bit-bots/bitbots_imu_dxl/electronics/imu_module/schematic.pdf

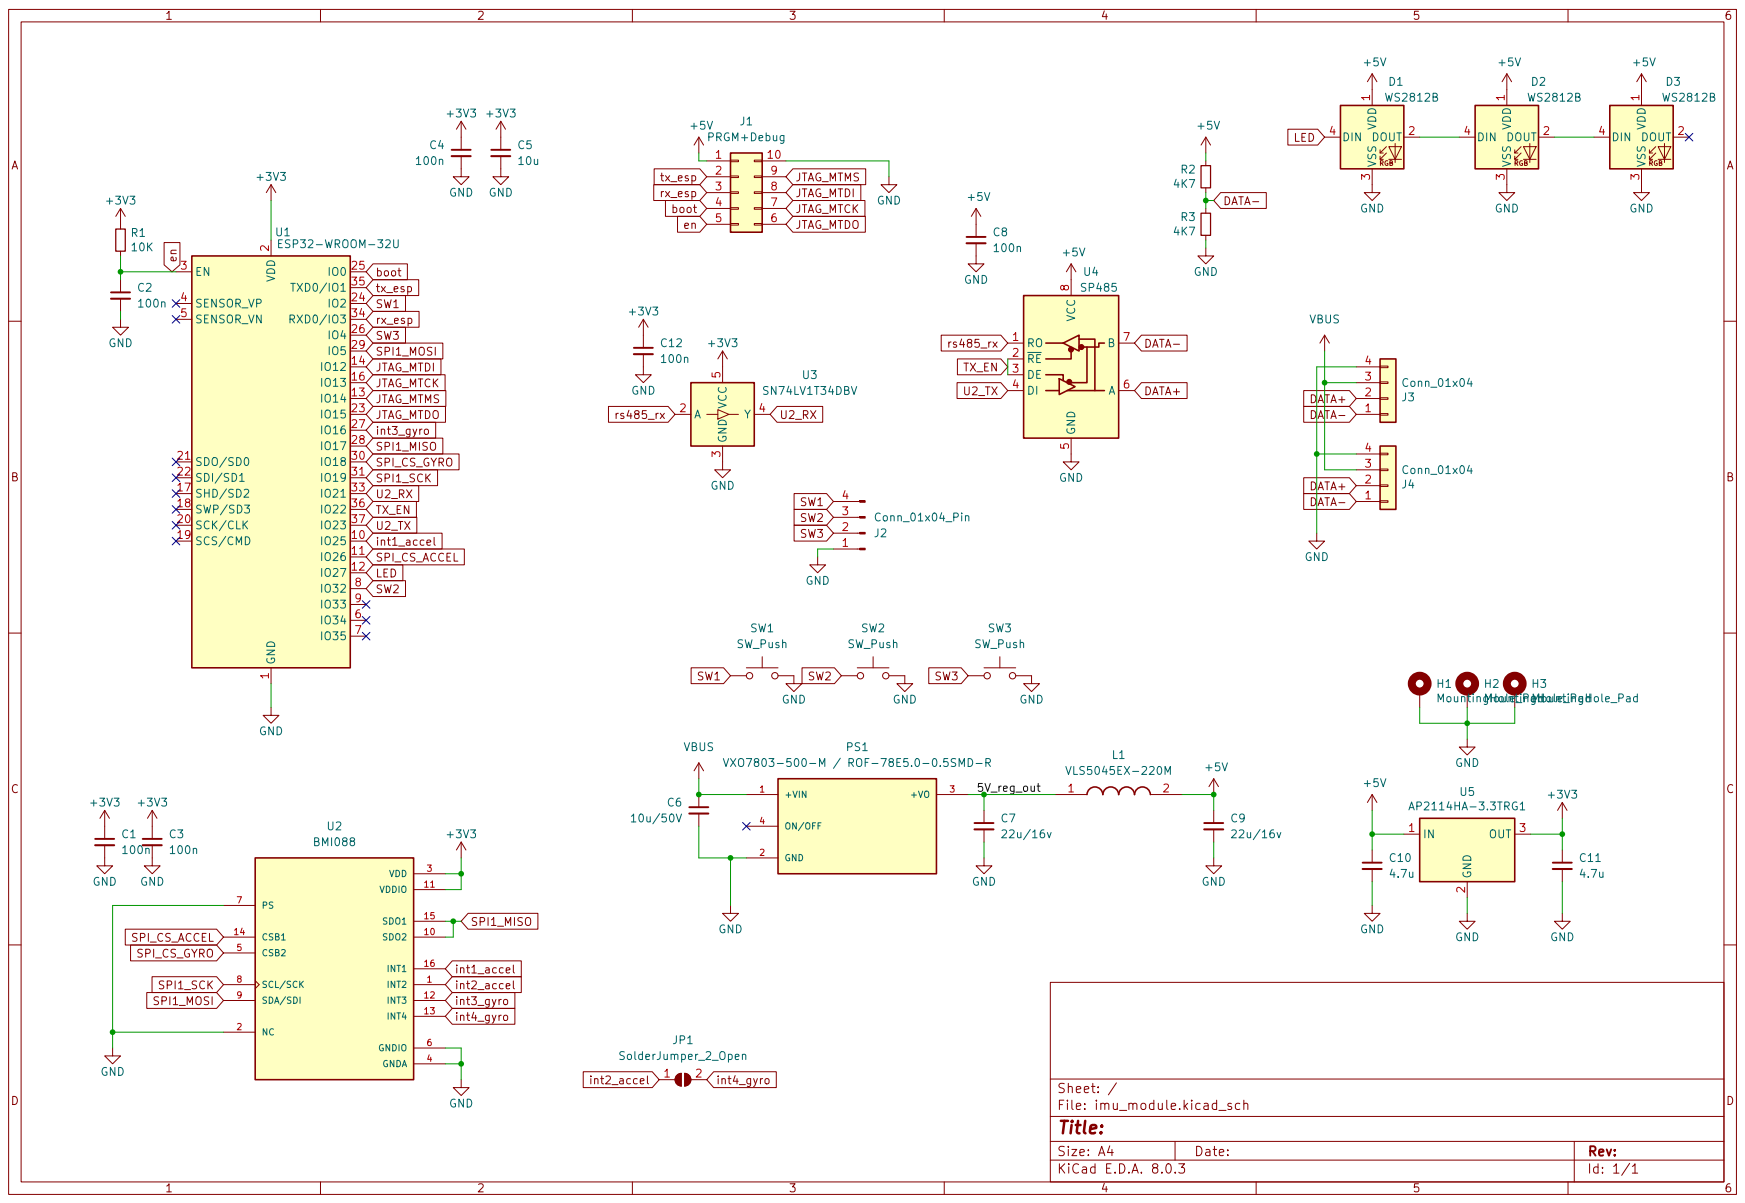
[picture p1: page 1]
