bit-bots/bitbots_imu_dxl/electronics/imu_module/imu_module.kicad_pcb

## KiCad design electronics/imu_module/imu_module.kicad_pcb (2024-07-10)

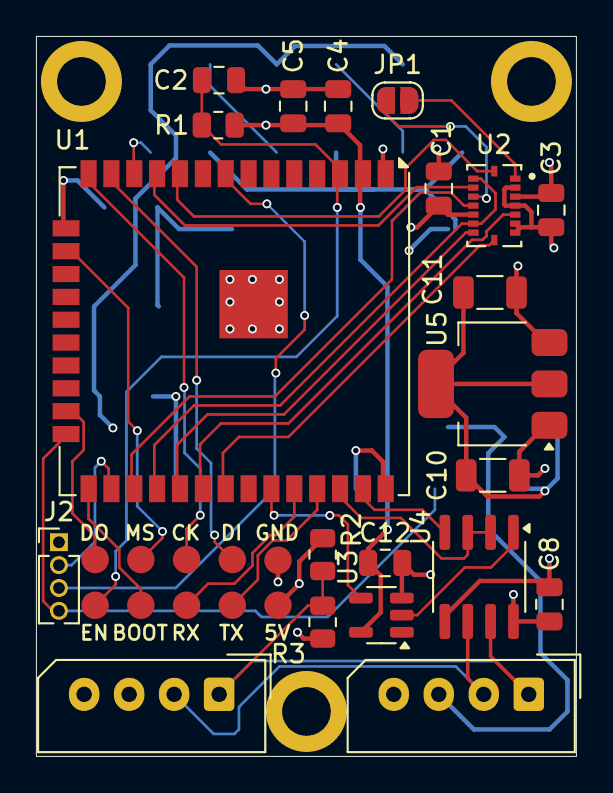
[picture p2: board imu_module.kicad_pcb from above]

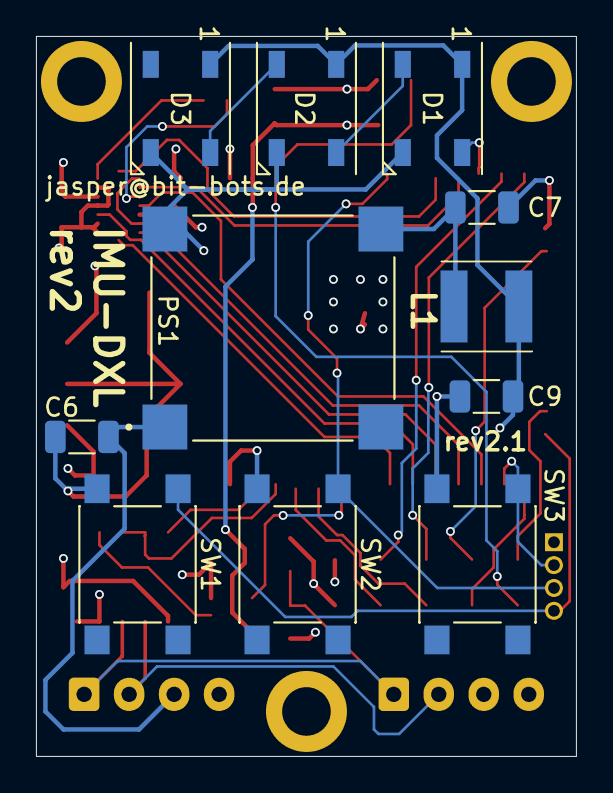
[picture p3: board imu_module.kicad_pcb from below]

Board: 4 copper layers, 30.0 x 40.0 mm, 36 parts (11 on the bottom side), 34 nets.

Parts:
C1, C2, C3, C4, C8, C12: 100n; C_0805_2012Metric
C5: 10u; C_0805_2012Metric
C6: 10u/50V; C_1206_3216Metric
C7, C9: 22u/16v; C_1206_3216Metric
C10, C11: 4.7u; C_1206_3216Metric
D1, D2, D3: WS2812B; LED_WS2812B_PLCC4_5.0x5.0mm_P3.2mm_marked
H1, H2, H3: MountingHole_Pad; MountingHole_2.7mm_M2.5_ISO14580_Pad
J1: PRGM+Debug; esp32_prgm_debug
J2: Conn_01x04_Pin; PinHeader_1x04_P1.27mm_Vertical
J3, J4: Conn_01x04; Molex_SPOX_5267-04A_1x04_P2.50mm_Vertical
JP1: SolderJumper_2_Open; SolderJumper-2_P1.3mm_Open_RoundedPad1.0x1.5mm
L1: VLS5045EX-220M; VLS5045EX330M
PS1: VXO7803-500-M; CONV_VXO7803-500-M
R1: 10K; R_0805_2012Metric
R2, R3: 4K7; R_0805_2012Metric
SW1, SW2, SW3: SW_Push; RND 210-00211
U1: ESP32-WROOM-32U; ESP32-WROOM-32UE
U2: BMI088
U3: SN74LV1T34DBV; SOT-23-5
U4: SP485; SOIC-8_3.9x4.9mm_P1.27mm
U5: AP2114HA-3.3TRG1; SOT-223-3_TabPin2

Connections:
+3V3: C1.1, C3.1, C4.1, C5.1, C11.1, C12.1, R1.1, U1.2 (VDD), U2.3 (VDD), U2.11 (VDDIO), U3.5 (VCC), U5.3 (OUT)
+5V: C8.1, C9.1, C10.1, D1.1 (VDD), D2.1 (VDD), D3.1 (VDD), J1.1, L1.2, R2.1, U4.8 (VCC), U5.1 (IN)
/5V_reg_out: C7.1, L1.1, PS1.3 (+VO)
DATA+: J3.2, J4.2, U4.6 (A)
DATA-: J3.1, J4.1, R2.2, R3.1, U4.7 (B)
GND: C1.2, C2.2, C3.2, C4.2, C5.2, C6.2, C7.2, C8.2, C9.2, C10.2, C11.2, C12.2, D1.3 (VSS), D2.3 (VSS), D3.3 (VSS), H1.1, H2.1, H3.1, J1.10, J2.1, J3.4, J4.4, PS1.2 (GND), R3.2, SW1.2, SW2.2, SW3.2, U1.1 (GND), U1.15 (GND), U1.38 (GND), U1.39 (GND), U2.2 (NC), U2.4 (GNDA), U2.6 (GNDIO), U2.7 (PS), U3.3 (GND), U4.5 (GND), U5.2 (GND)
JTAG_MTCK: J1.7, U1.16 (IO13)
JTAG_MTDI: J1.8, U1.14 (IO12)
JTAG_MTDO: J1.6, U1.23 (IO15)
JTAG_MTMS: J1.9, U1.13 (IO14)
LED: D1.4 (DIN), U1.12 (IO27)
unnamed: D1.2 (DOUT), D2.4 (DIN)
unnamed: D2.2 (DOUT), D3.4 (DIN)
SPI1_MISO: U1.28 (IO17), U2.10 (SDO2), U2.15 (SDO1)
SPI1_MOSI: U1.29 (IO5), U2.9 (SDA/SDI)
SPI1_SCK: U1.31 (IO19), U2.8 (SCL/SCK)
SPI_CS_ACCEL: U1.11 (IO26), U2.14 (CSB1)
SPI_CS_GYRO: U1.30 (IO18), U2.5 (CSB2)
SW1: J2.4, SW1.1, U1.24 (IO2)
SW2: J2.3, SW2.1, U1.8 (IO32)
SW3: J2.2, SW3.1, U1.26 (IO4)
TX_EN: U1.36 (IO22), U4.2 (~RE), U4.3 (DE)
U2_RX: U1.33 (IO21), U3.4 (Y)
U2_TX: U1.37 (IO23), U4.4 (DI)
VBUS: C6.1, J3.3, J4.3, PS1.1 (+VIN)
boot: J1.4, U1.25 (IO0)
en: C2.1, J1.5, R1.2, U1.3 (EN)
int1_accel: U1.10 (IO25), U2.16 (INT1)
int2_accel: JP1.1 (A), U2.1 (INT2)
int3_gyro: U1.27 (IO16), U2.12 (INT3)
int4_gyro: JP1.2 (B), U2.13 (INT4)
rs485_rx: U3.2 (A), U4.1 (RO)
rx_esp: J1.3, U1.34 (RXD0/IO3)
tx_esp: J1.2, U1.35 (TXD0/IO1)
