bit-bots/bitbots_imu_dxl/(threads)

Thread 6 (2023-01-04):

Use 16bit float instead of 32

SammyRamone, 2023-01-04:
Currently we use 32 bit precision float for accel, gyro and quaternion values. The IMU itself only provides 16bit precision so it does not make sense to use a more precise type.
This would reduce the number of bytes on the bus and allow faster reading.
