bit-bots/bitbots_imu_dxl/(commit log)

2020-06-26 add pcb, schematic and firmware
2020-08-12 calibrate accel
2020-08-17 move read to loop, add accel calibration
2020-08-25 fix gyro order and quaternion order
2021-01-19 bom and gerber
    [BOM.csv]
2021-12-02 kicad gitignore
2021-12-02 rm old files
    [BOM.csv]
2021-12-02 add new files
    [imu_module.sch]
2021-12-02 add footprint lib table
2021-12-02 start pcb
    [imu_module.kicad_pcb, imu_module.sch]
2024-01-04 kicad project files
2024-02-02 Changed Pin configuration and variables
2024-02-06 "Split acc and gyro flag, currently running script"
2024-03-15 Add imu test script
2024-03-17 working dxl with with esp32 idf
2024-03-17 port and led brightness
2024-03-18 pin versions of libraries and platform
2024-03-18 update to kicad 8.0.1
    [imu_module.kicad_pcb, imu_module.kicad_sch]
2024-03-18 rm output files
    [imu_module-B_Cu.gbr, imu_module-B_Mask.gbr, imu_module-B_Paste.gbr, imu_module-B_Silkscreen.gbr, imu_module-Edge_Cuts.gbr, imu_module-F_Cu.gbr, imu_module-F_Mask.gbr, imu_module-F_Paste.gbr]
2024-03-18 rm gerber files
    [imu_module-B_Cu.gbr, imu_module-B_Mask.gbr, imu_module-B_Paste.gbr, imu_module-B_Silkscreen.gbr, imu_module-Edge_Cuts.gbr, imu_module-F_Cu.gbr, imu_module-F_Mask.gbr, imu_module-F_Paste.gbr]
2024-03-18 library updates
    [imu_module.kicad_pcb, imu_module.kicad_sch]
2024-03-18 rm production files as design is not quite finalized
    [bom.csv, designators.csv, positions.csv]
2024-03-18 more cleanup and 3d models
    [imu_module.kicad_pcb]
2024-03-18 prep for production
    [bom.csv, designators.csv, imu_module.kicad_pcb, imu_module.kicad_sch, positions.csv]
2024-03-20 better support for bmi088 sensor
2024-03-21 new routing for buttons + leds on board
    [bom.csv, designators.csv, imu_module.kicad_pcb, imu_module.kicad_sch, positions.csv]
2024-06-24 production version and bom
    [bom.csv, designators.csv, imu_module.kicad_pcb, imu_module.kicad_sch, positions.csv]
2024-06-24 pin definitions and 3rd button
2024-12-03 add schematic pdf
2025-02-14 Add first version of a rust dynamixel device
2025-03-04 Current working state
2025-03-04 Add led driver
2025-03-06 Fix led order
2025-03-07 Correctly orient imu
2025-03-07 Add version that works with 500Hz cycle
2025-03-08 Honor profiling flag for imu loop freq
2025-03-08 Use git version of imu driver
2025-03-08 Add button support
2025-03-15 Print ping after answer
